killboxalpha/nanoreflow/hardware/v1_0_powering_options.pdf

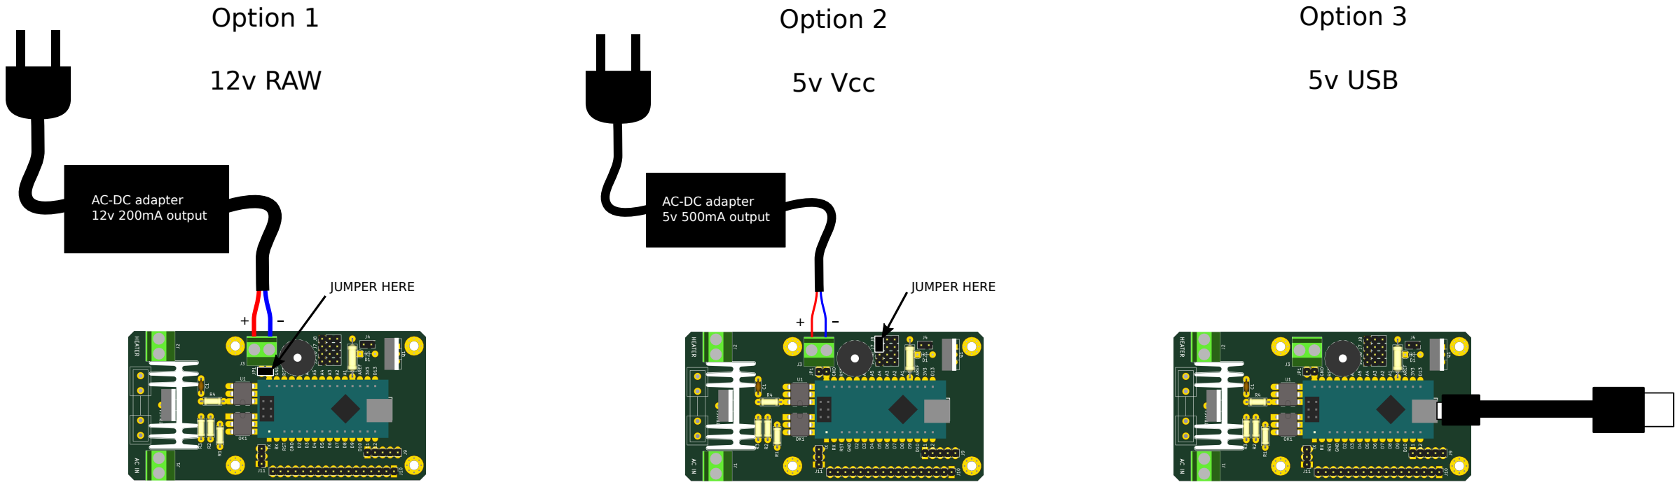
[picture p7: figure]
AC-DC adapter 12v 200mA output; AC-DC adapter 5v 500mA output; JUMPER HERE; Option 1; 12v RAW; Option 2; 5v Vcc; Option 3; 5v USB
