killboxalpha/nanoreflow/hardware/v1_0_PCB.png

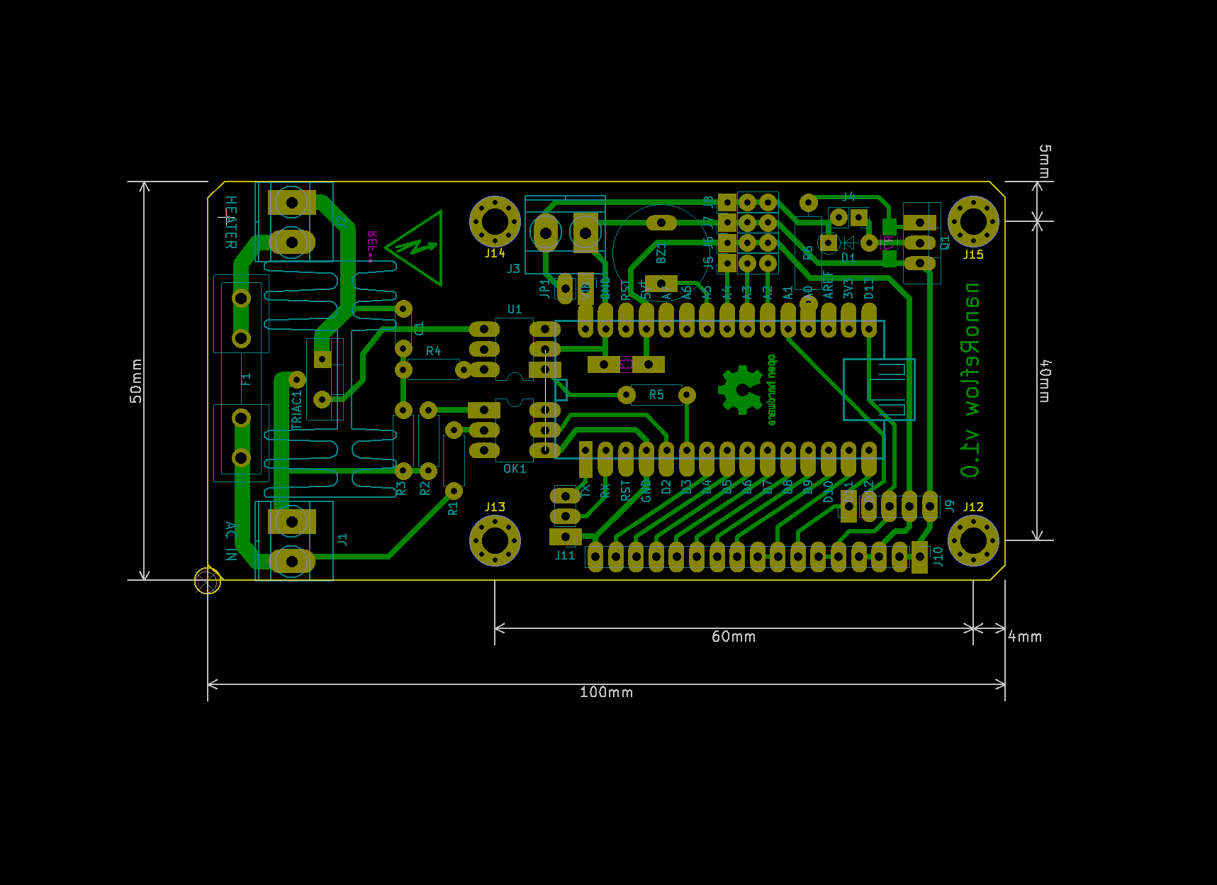
hardware/v1_0_PCB.png
