killboxalpha/nanoreflow/hardware/v1_0_schematic.png

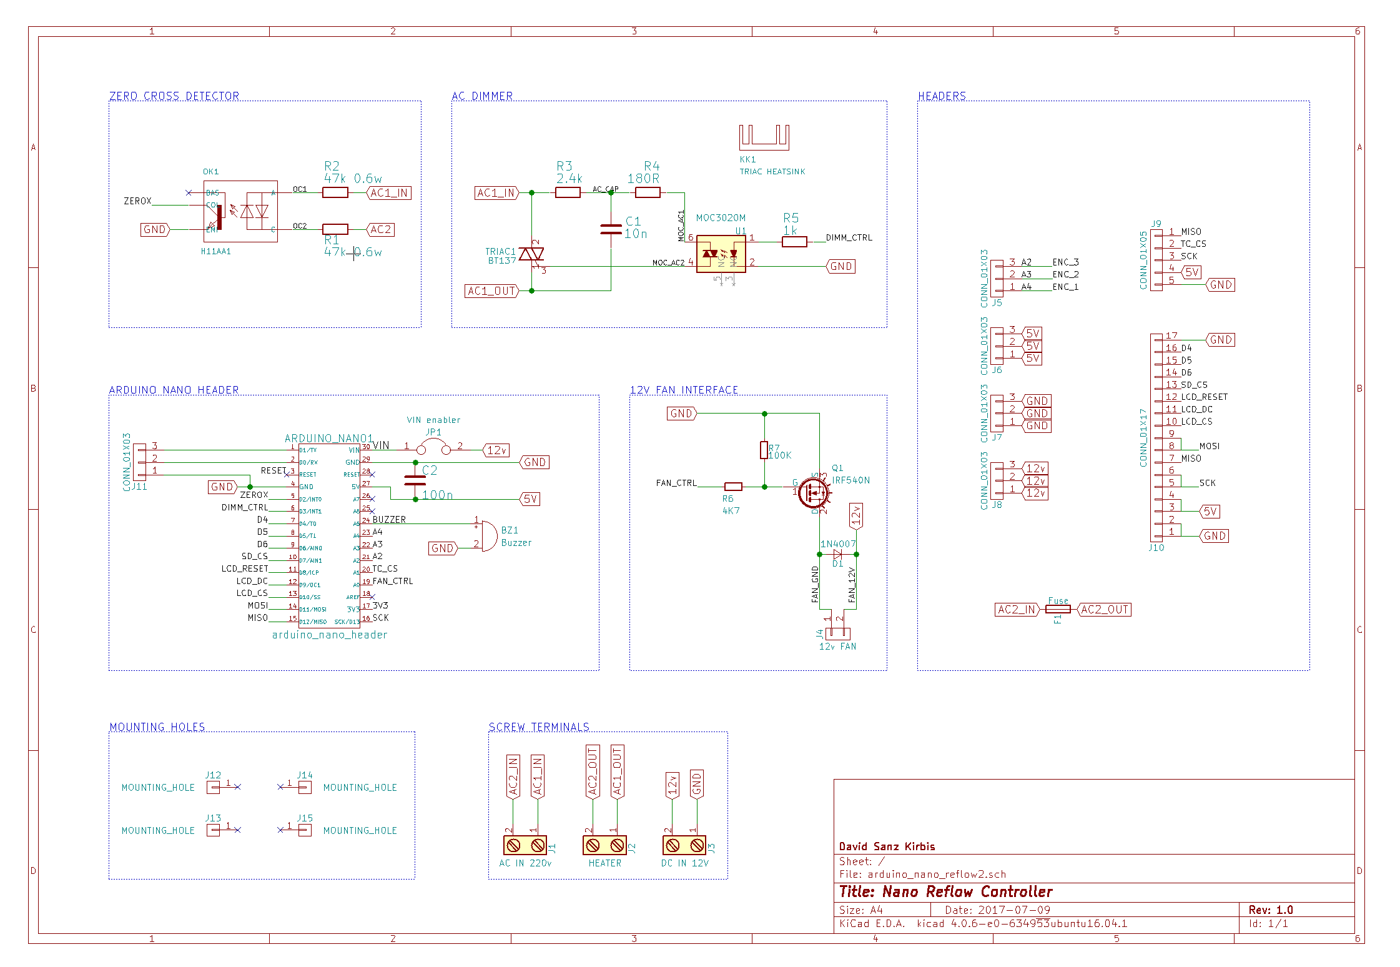
hardware/v1_0_schematic.png
