killboxalpha/nanoreflow/hardware/v1_0_connections.pdf

# encoder module LED SCK SDAAO RESET

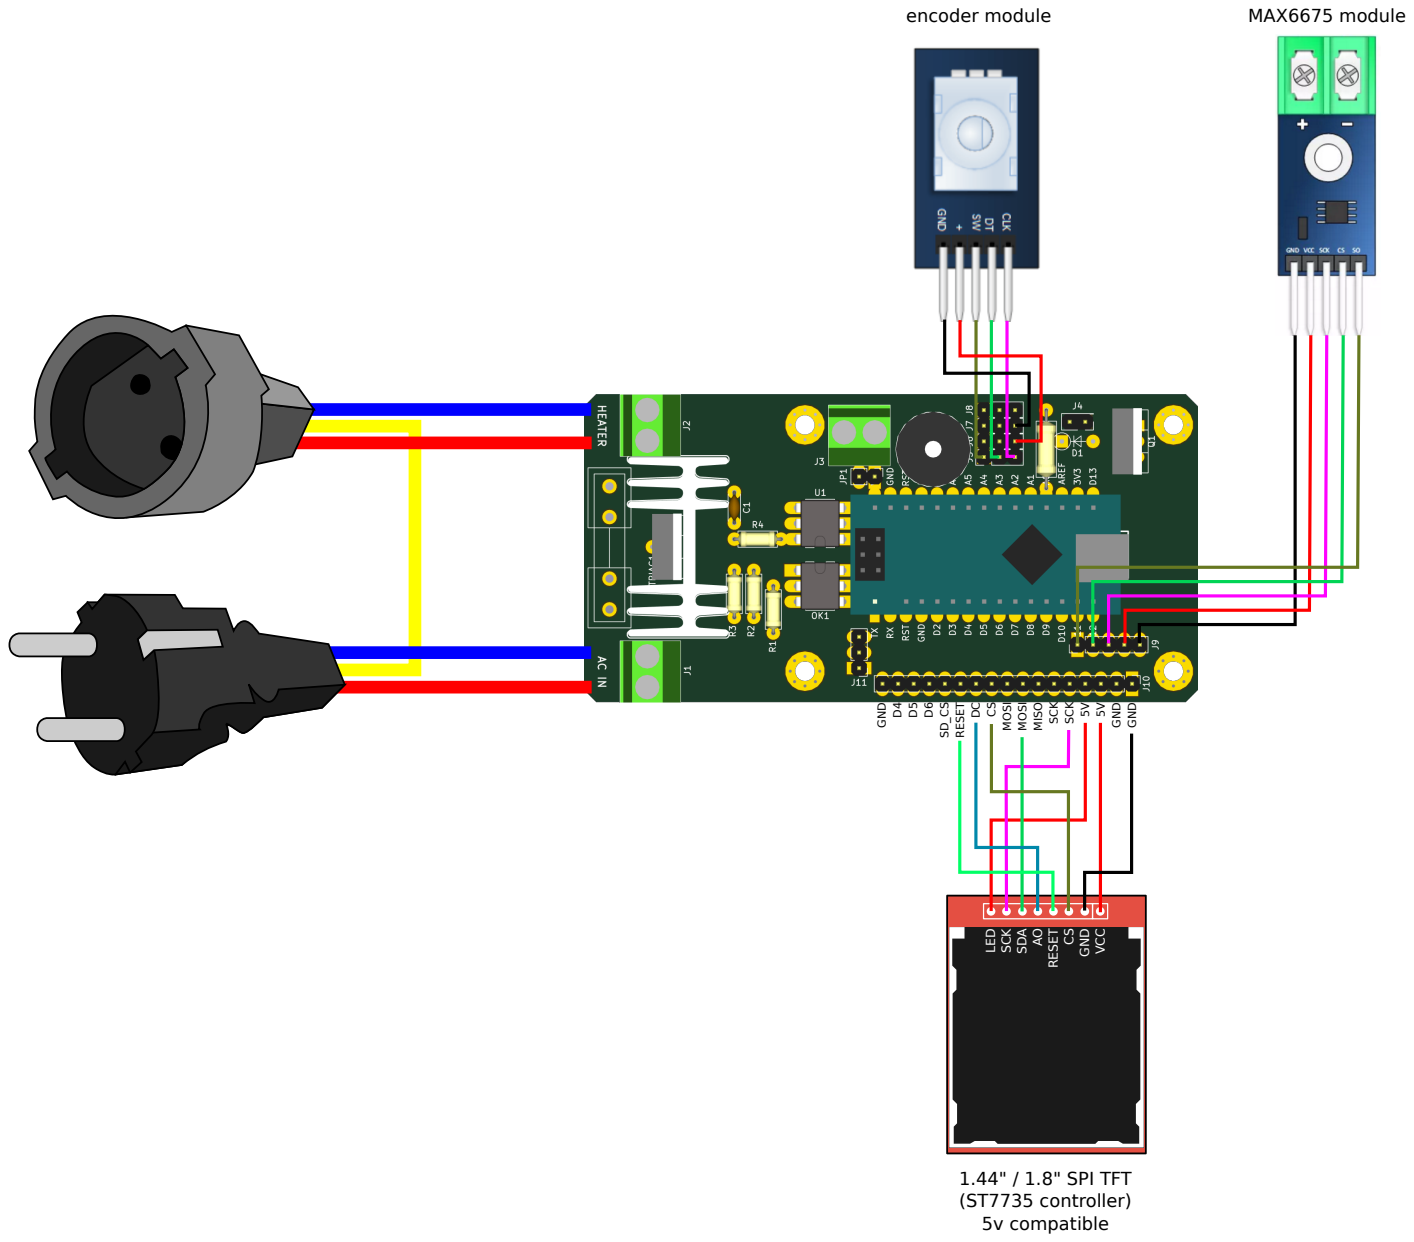
[picture p10: page 1]
GND; VCC; RESET; MOSI; MISO; SCK; MAX6675 module; 1.44" / 1.8" SPI TFT (ST7735 controller) 5v compatible
