killboxalpha/nanoreflow/hardware/v1_0_schematic.pdf

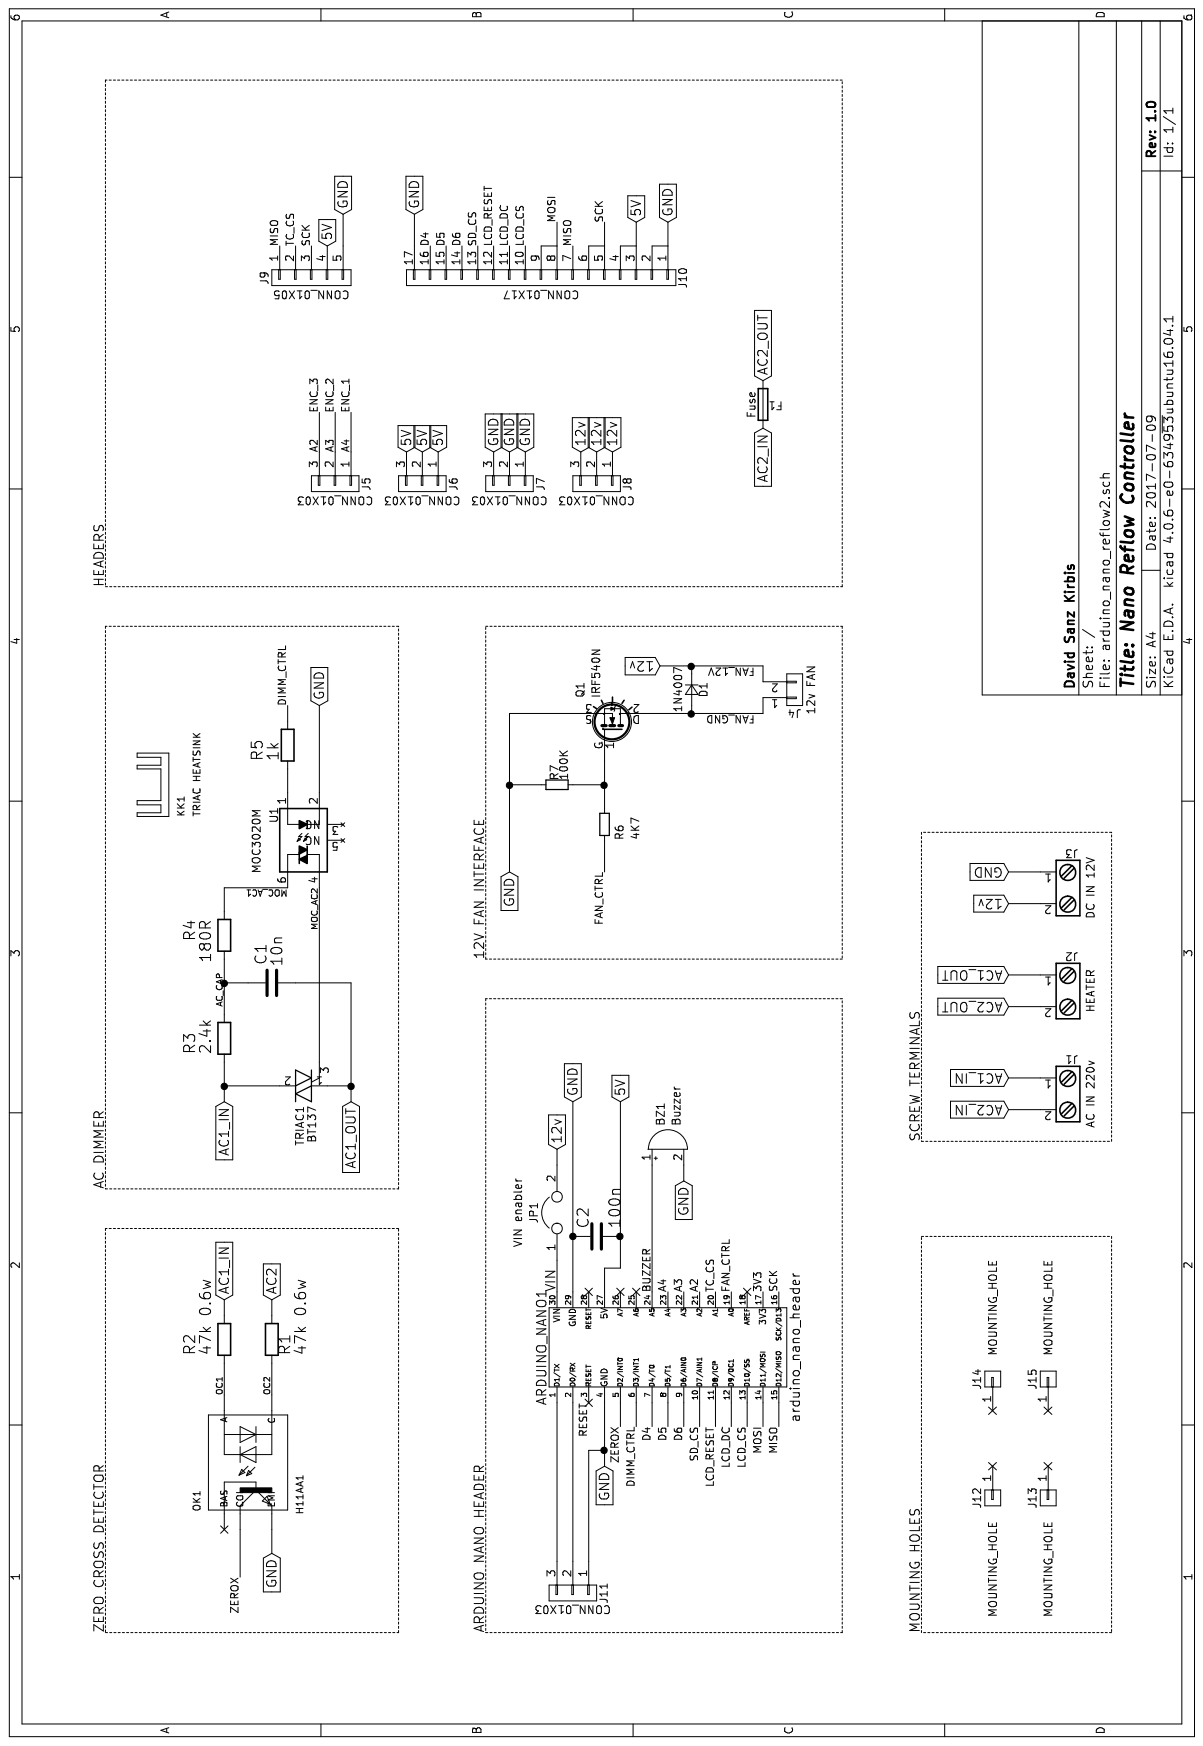
[picture p11: page 1]
