killboxalpha/nanoreflow/hardware/v1_0_PCB_toner.pdf

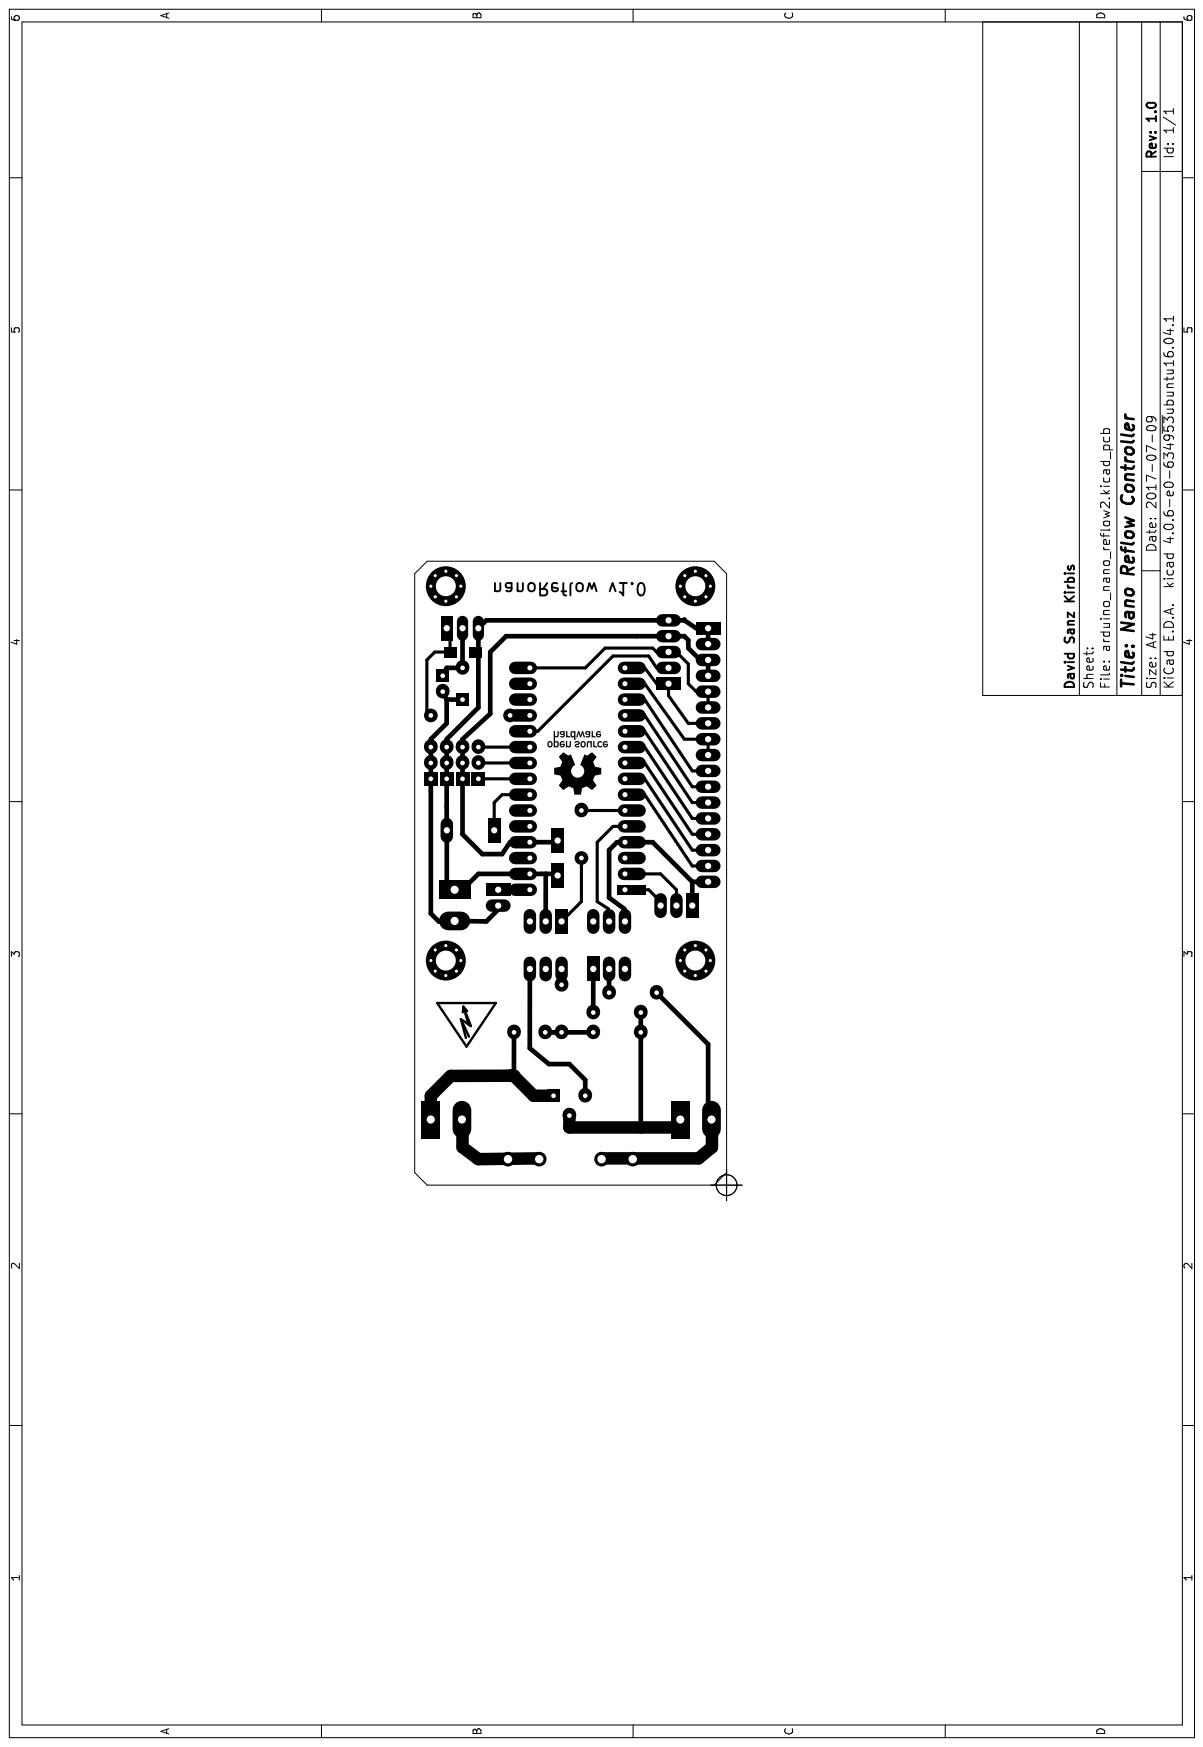
[picture p12: page 1]
