killboxalpha/nanoreflow/(commit log)

2015-03-08 Beeper added
    Adds some audio feedback for init (very short beep), error (long beep),
    start of cooldown phase (short beep) and end of reflow process (three
    beeps).
    Unfortunately, the sketch size gets too long for the Leonardo. Some
    other code has to be removed in order to successfully flash this.
    [ReflowController.ino]
2017-06-03 Update schematics
2017-06-18 Switch from digitalWriteFast to portMacros.h
2017-07-09 update board from SSR to TRIAC/DIAC
2017-07-09 change some PCB ways widths
2017-07-10 move PCB holes
2017-07-10 add fuse to PCB
    [v1_0_bom.csv]
2017-07-10 add powering info
2017-07-11 typo correction in powering info
    [config.h]
2017-07-12 add kicad zip packed sources
2017-08-09 encoder submodule
